logxen/contraptor/README.md

Contraptor
==========

Contraptor is a DIY open source construction set for experimental personal fabrication, desktop manufacturing, prototyping and bootstrapping. http://www.contraptor.org/
