logxen/contraptor/tags/contraptor-1.5.0/components/electronics/electronics.readme.htm

# Electronics

### Stepper Motors



I'm currently using cheap Applied Motion Products unipolar stepper motors 44A501711. They are rated for 2.3A / 2.3V / 60 oz*in. This is technically beyond the limit of the stepper driver board, but because the board has current limiting capability, it works. I do make sure that the driver boards are heatsinked to the frame whenever I run these steppers.

### Stepper Driver Board

The set originally used Reprap stepper driver board v1.1, but this board is no longer available. You can buy very similar v1.2 stepper driver board from makerbot.com, which sells kits derived from Reprap designs. One board kit costs $26: http://store.makerbot.com/electronics/electronics-kits/stepper-motor-dri...

The RepRap wiki has detailed instructions (http://www.reprap.org/bin/view/Main/Stepper_Motor_Driver_1_2) for soldering this board. The difference between v1.1 and v1.2 is primarily in connectors: v1.2 uses CAT5 for MIN/MAX and IDC for Arduino connection (compare to v1.1 (http://www.reprap.org/bin/view/Main/Stepper_Motor_Driver_1_1)). I actually prefer the MIN/MAX connectors in v1.1, and they can still be used with v1.2 board.

Alternatively, you can order parts through the parts lister on the Reprap page and etch your own PCBs using these the trace files here: http://forums.reprap.org/read.php?13,8181

You need as many boards as the axes you want to control at a time.

### Arduino Controller

You can buy it for little over $30 (http://www.arduino.cc/en/Main/Buy). You can also make or get Freeduino (http://www.google.com/search?q=freeduino) which may be cheaper.

### ATX power supply

The PSU can be scavenged from just about any old PC or bought at computer supply stores.
