logxen/contraptor/tags/contraptor-1.5.0/contraptions/mini-router/_screenshot.png

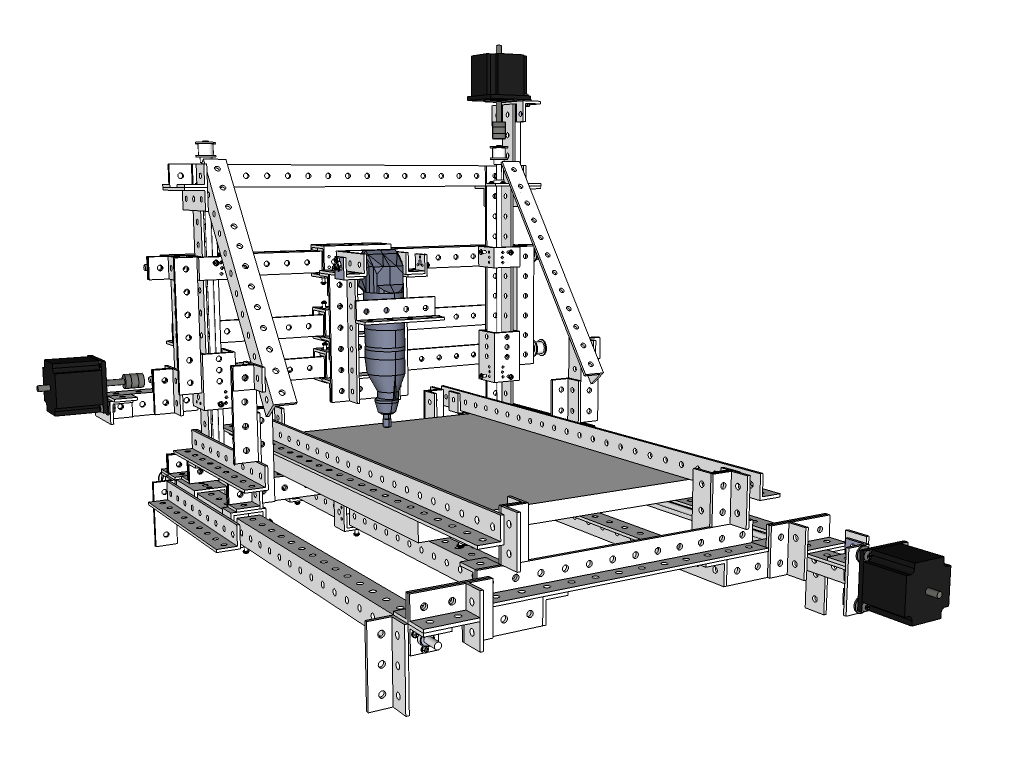
tags/contraptor-1.5.0/contraptions/mini-router/_screenshot.png
