logxen/contraptor/tags/contraptor-1.5.0/examples/belt-drive/_screenshot.png

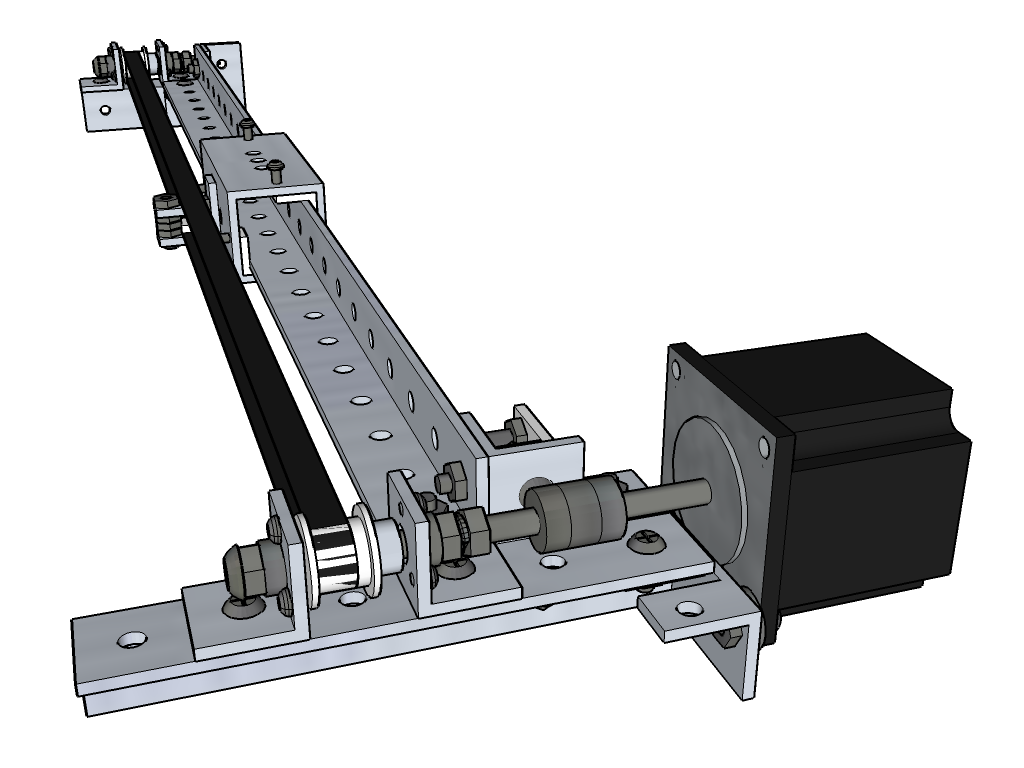
tags/contraptor-1.5.0/examples/belt-drive/_screenshot.png
