logxen/contraptor/tags/contraptor-1.5.0/examples/leadscrew-drive/_screenshot.png

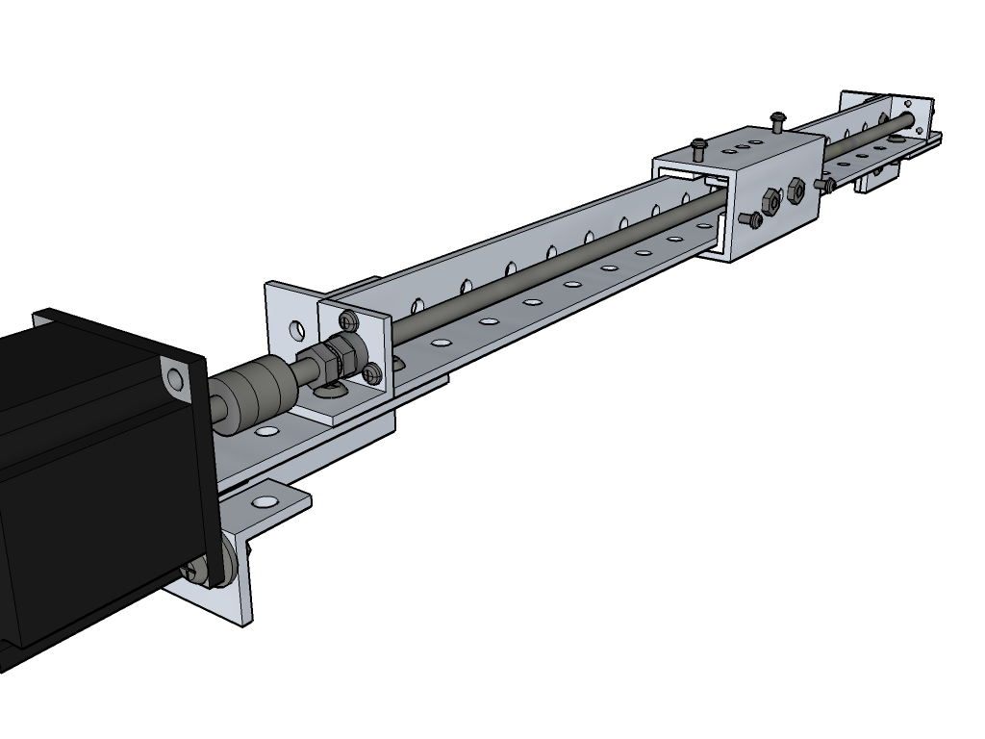
tags/contraptor-1.5.0/examples/leadscrew-drive/_screenshot.png
