logxen/contraptor/trunk/contraptions/xy-plotter/_screenshot.png

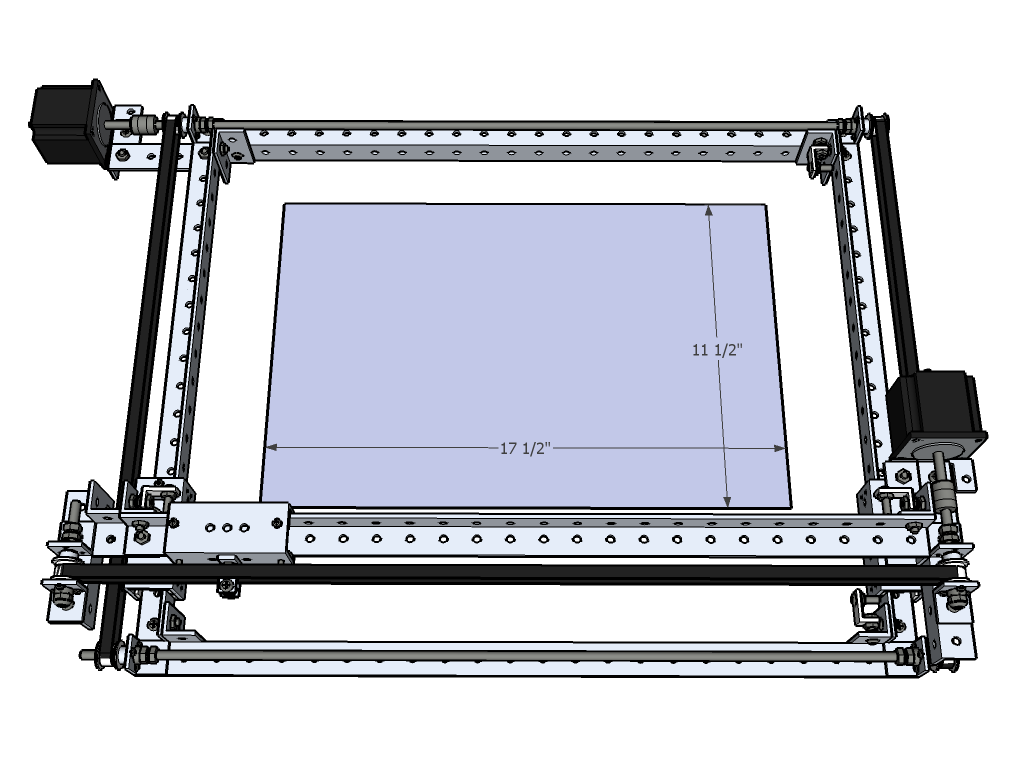
trunk/contraptions/xy-plotter/_screenshot.png
