logxen/contraptor/tags/contraptor-1.5.0/components/belt-clamp/belt-clamp.3d.DXF

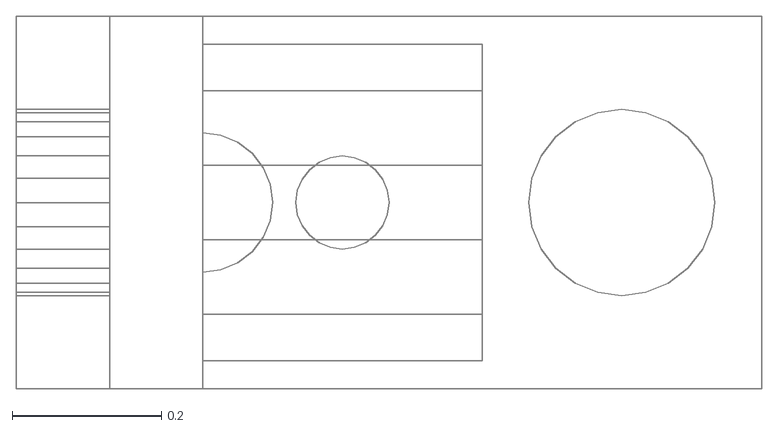
[picture p5: CAD file, 2009-03-20]
tags/contraptor-1.5.0/components/belt-clamp/belt-clamp.3d.DXF
1.00 x 0.5
