logxen/contraptor/tags/contraptor-1.5.0/components/leadnut-mount/leadnut-mount.3d.DXF

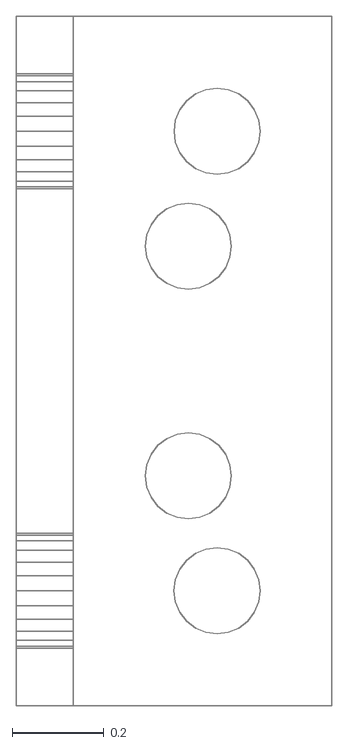
[picture p6: CAD file, 2009-03-20]
tags/contraptor-1.5.0/components/leadnut-mount/leadnut-mount.3d.DXF
0.688 x 1.50
