logxen/contraptor/tags/contraptor-1.5.0/components/motor-mount-nema23/motor-mount-nema23.3d.DXF

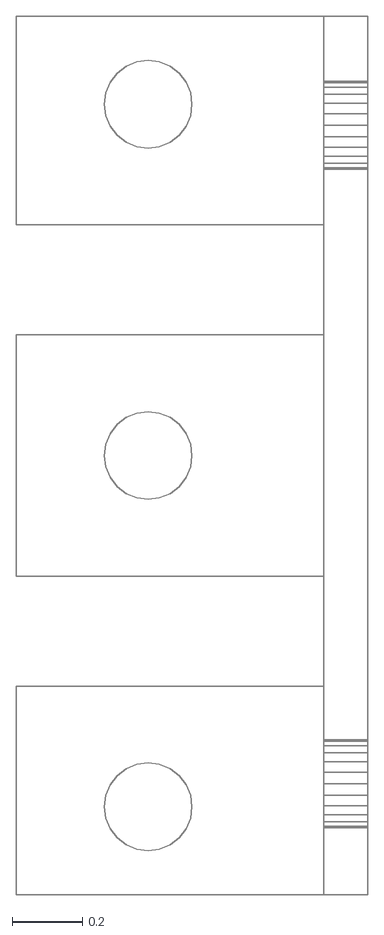
[picture p7: CAD file, 2009-03-20]
tags/contraptor-1.5.0/components/motor-mount-nema23/motor-mount-nema23.3d.DXF
1.00 x 2.50
