logxen/contraptor/tags/contraptor-1.5.0/components/perforated-angle/perforated-angle.3d.dxf

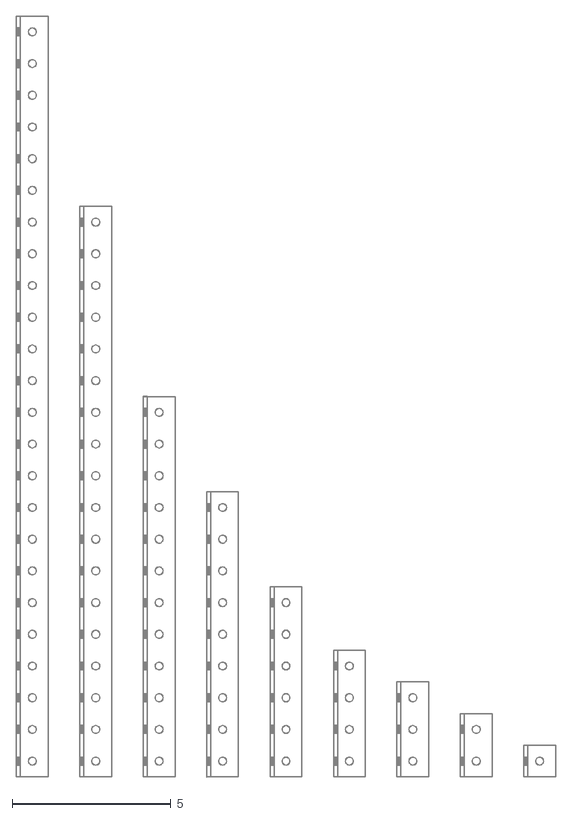
[picture p8: CAD file, 2009-03-20]
tags/contraptor-1.5.0/components/perforated-angle/perforated-angle.3d.dxf
17.0 x 24.0
