logxen/contraptor/tags/contraptor-1.5.0/components/shaft-mount/shaft-mount.3d.DXF

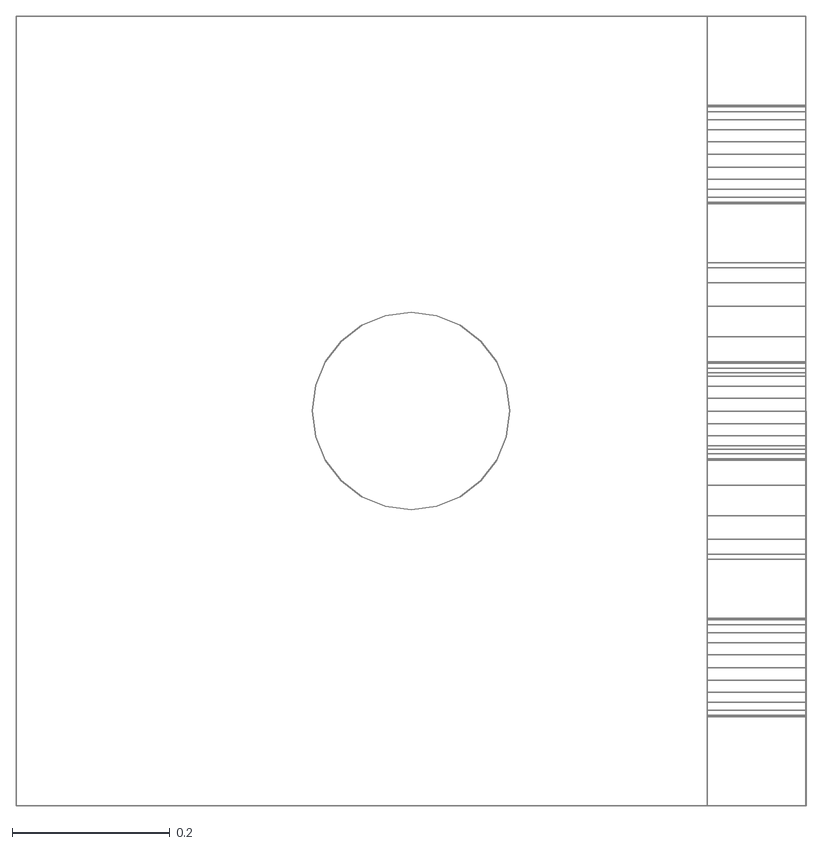
[picture p9: CAD file, 2009-03-20]
tags/contraptor-1.5.0/components/shaft-mount/shaft-mount.3d.DXF
1.00 x 1
