logxen/contraptor/tags/contraptor-1.5.0/components/sliding-elements/sliding-element-1/sliding-element-1.3d.DXF

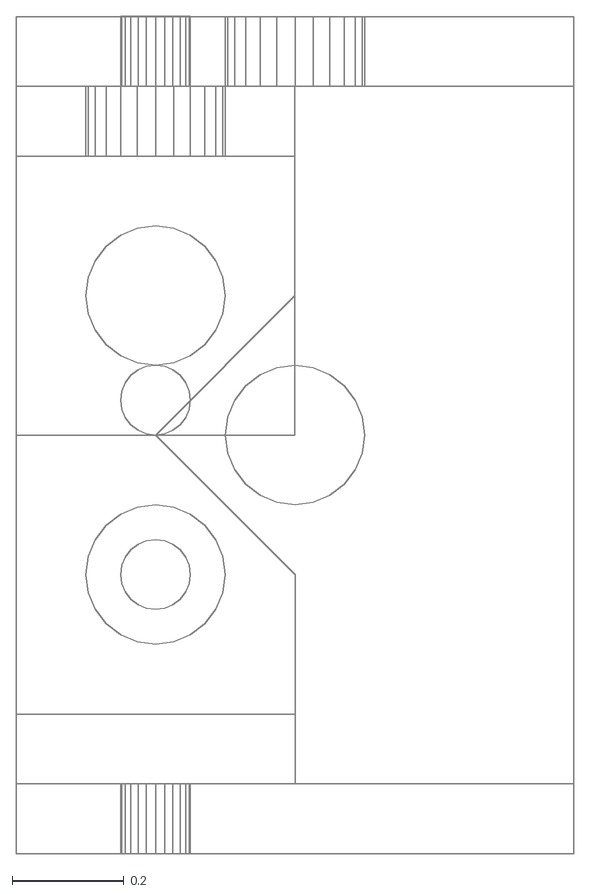
[picture p10: CAD file, 2009-03-20]
tags/contraptor-1.5.0/components/sliding-elements/sliding-element-1/sliding-element-1.3d.DXF
1.00 x 1.50
