logxen/contraptor/tags/contraptor-1.5.0/components/sliding-elements/sliding-element-3.5/sliding-element-3.5.3d.DXF

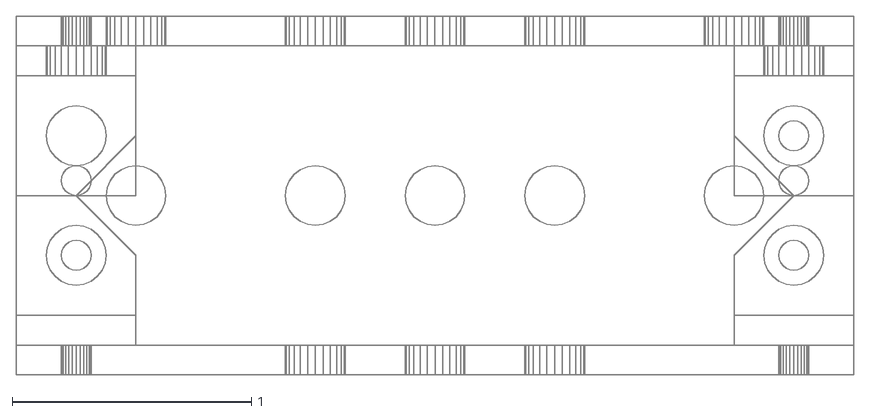
[picture p12: CAD file, 2009-03-20]
tags/contraptor-1.5.0/components/sliding-elements/sliding-element-3.5/sliding-element-3.5.3d.DXF
3.50 x 1.50
