logxen/contraptor/trunk/components/motor-mount-nema23/motor-mount-nema23.3d.DXF

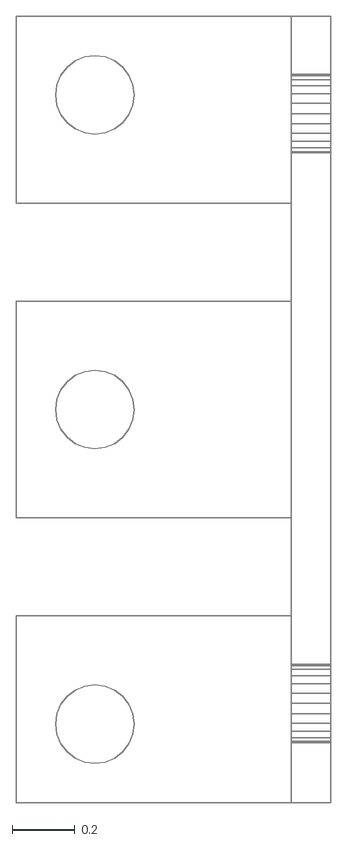
[picture p13: CAD file, 2009-09-23]
trunk/components/motor-mount-nema23/motor-mount-nema23.3d.DXF
1.00 x 2.50
