logxen/contraptor/tags/contraptor-1.5.0/components/coupling-nut-clamp/coupling-nut-clamp.3d.DXF

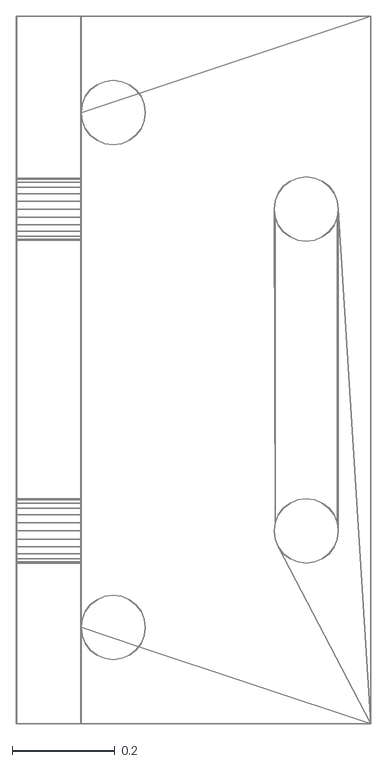
[picture p15: CAD file, 2009-03-20]
tags/contraptor-1.5.0/components/coupling-nut-clamp/coupling-nut-clamp.3d.DXF
0.688 x 1.38
