logxen/contraptor/(list of files, cad)

Other CAD files:
tags/contraptor-1.5.0/components/belt-clamp/belt-clamp.3d.skp
tags/contraptor-1.5.0/components/captive-nut/captive-nut.3d.skp
tags/contraptor-1.5.0/components/contraptor.3d.skp
tags/contraptor-1.5.0/components/coupling-nut-clamp/coupling-nut-clamp.3d.skp
tags/contraptor-1.5.0/components/leadnut-mount/leadnut-mount.3d.skp
tags/contraptor-1.5.0/components/motor-mount-nema23/motor-mount-nema23.3d.skp
tags/contraptor-1.5.0/components/perforated-angle/perforated-angle.3d.skp
tags/contraptor-1.5.0/components/shaft-mount/shaft-mount.3d.skp
tags/contraptor-1.5.0/components/sliding-elements/sliding-element-1/sliding-element-1.3d.skp
tags/contraptor-1.5.0/components/sliding-elements/sliding-element-2.5/sliding-element-2.5.3d.skp
tags/contraptor-1.5.0/components/sliding-elements/sliding-element-3.5/sliding-element-3.5.3d.skp
tags/contraptor-1.5.0/examples/belt-drive/belt-drive.3d.skp
tags/contraptor-1.5.0/examples/leadscrew-drive/leadscrew-drive.3d.skp
trunk/components/contraptor.3d.skp
trunk/components/motor-mount-nema23/motor-mount-nema23.3d.skp
trunk/contraptions/xy-plotter/xy-plotter.3d.skp
