logxen/contraptor/trunk/components/electronics/wiring.pdf

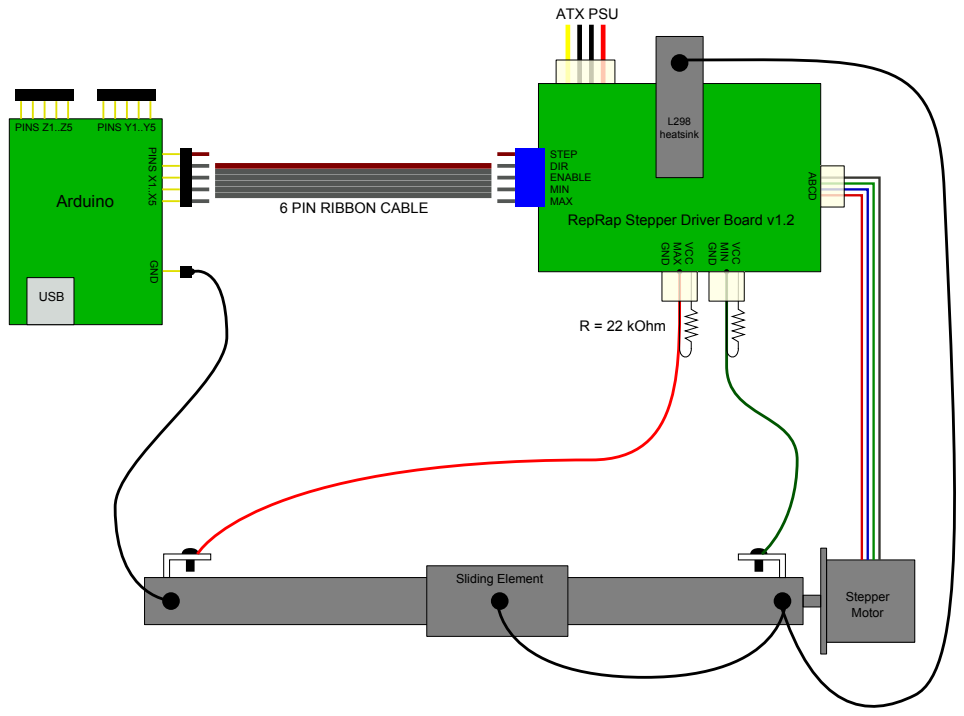
[picture p16: page 1]
PINS Y1..Y5; Arduino; Stepper Motor; Sliding Element; MIN; R = 22 kOhm; ATX PSU; L298 heatsink; USB; ABC; PIN; PINS Z1..Z5

STEP
DIR
ENABLE
MIN
MAX
RepRap Stepper Driver Board v1.2

6 PIN RIBBON CABLE
