logxen/contraptor/trunk/components/motor-mount-nema23/motor-mount-nema23.template.pdf

# CONTRAPTOR

### garageFab.cc/contraptor

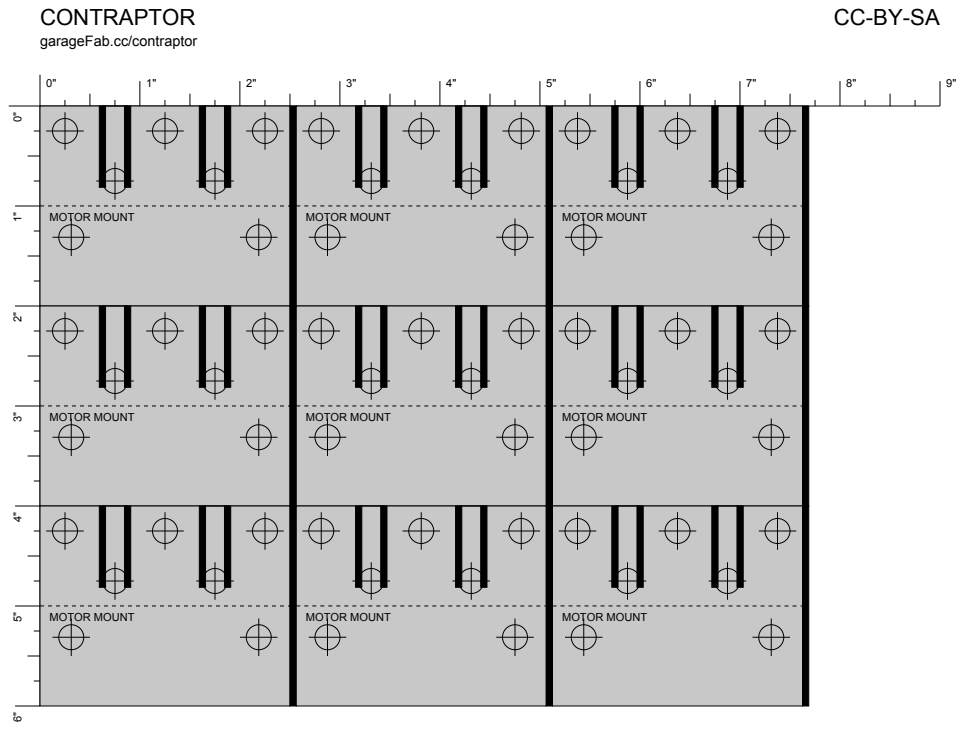
[picture p17: page 1]
MOTOR MOUNT
