logxen/contraptor/tags/contraptor-1.5.0/components/belt-clamp/belt-clamp.template.pdf

# CONTRAPTOR

### garageFab.cc/contraptor

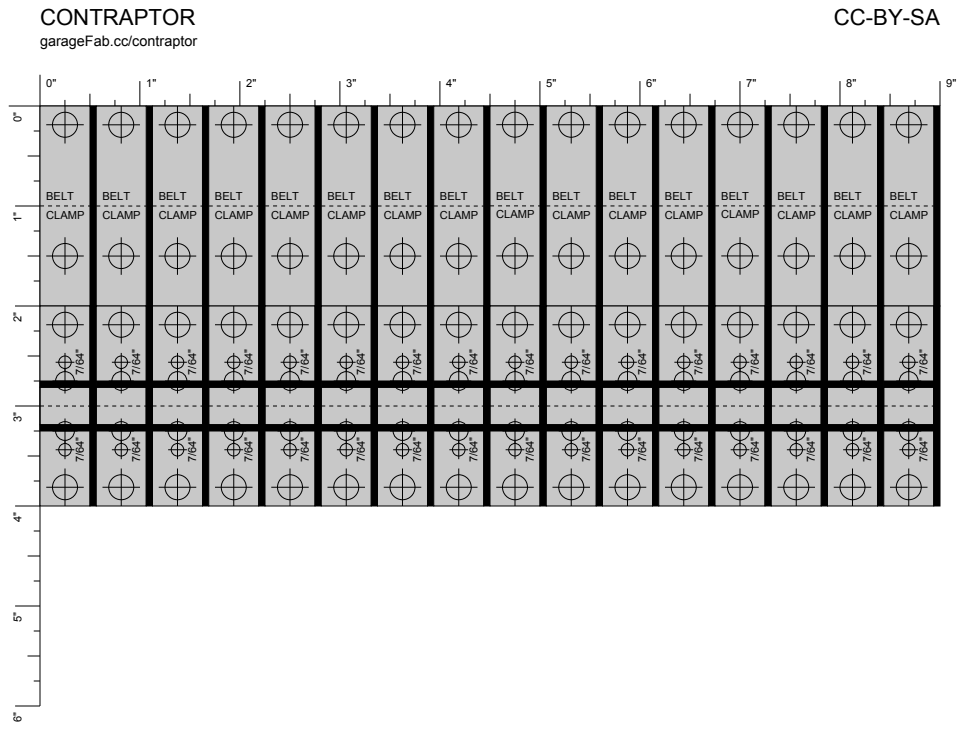
[picture p18: page 1]
BELT; CLAMP
