logxen/contraptor/tags/contraptor-1.5.0/components/captive-nut/captive-nut.template.pdf

# CONTRAPTOR

### garageFab.cc/contraptor

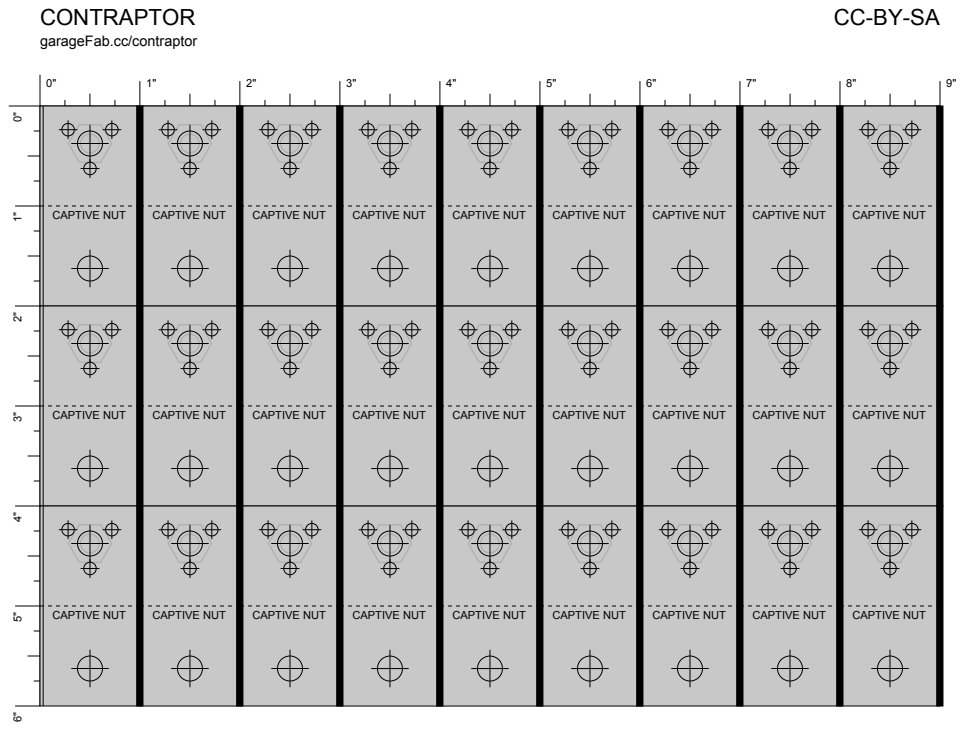
[picture p19: page 1]
CAPTIVE NUT
