logxen/contraptor/tags/contraptor-1.5.0/components/coupling-nut-clamp/coupling-nut-clamp.template.pdf

# CONTRAPTOR

### garageFab.cc/contraptor

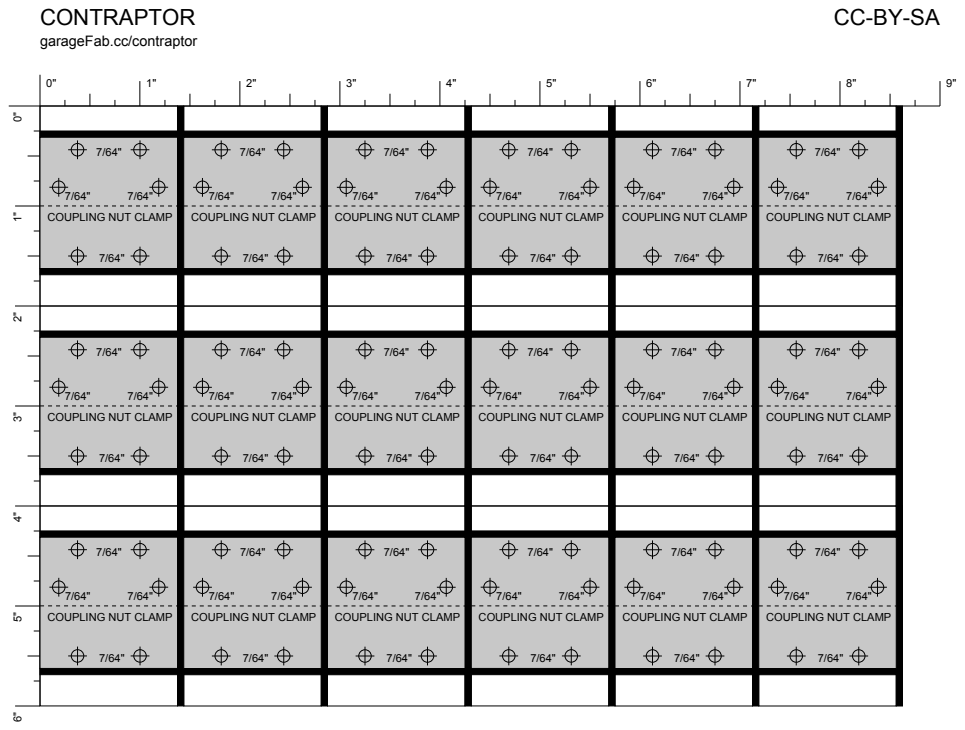
[picture p20: page 1]

COUPLING NUT CLAMP
