logxen/contraptor/tags/contraptor-1.5.0/components/electronics/wiring.pdf

## ATX PSU

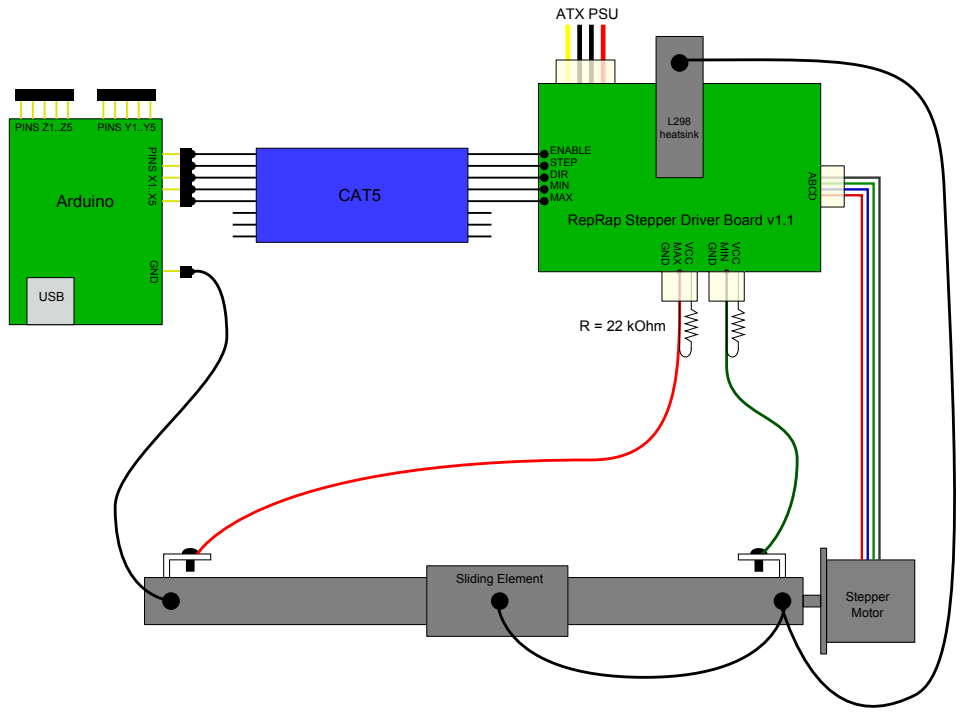
[picture p21: page 1]
ENABLE STEP DIR; MIN CAT5; MAX; PINS Y1..Y5; Arduino; Stepper Motor; Sliding Element; MIN; R = 22 kOhm; L298 heatsink; USB; ABC; PIN; PINS Z1..Z5

RepRap Stepper Driver Board v1.1
