logxen/contraptor/tags/contraptor-1.5.0/components/leadnut-mount/leadnut-mount.template.pdf

# CONTRAPTOR

### garageFab.cc/contraptor

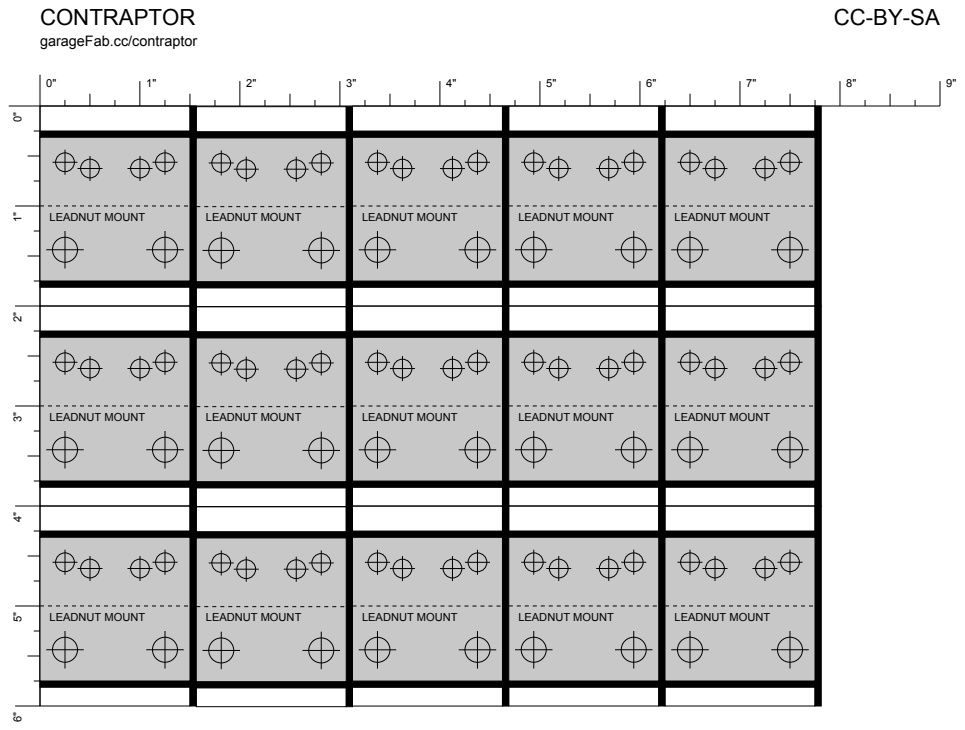
[picture p22: page 1]
LEADNUT MOUNT
