logxen/contraptor/tags/contraptor-1.5.0/components/motor-mount-nema23/motor-mount-nema23.template.pdf

# CONTRAPTOR

### garageFab.cc/contraptor

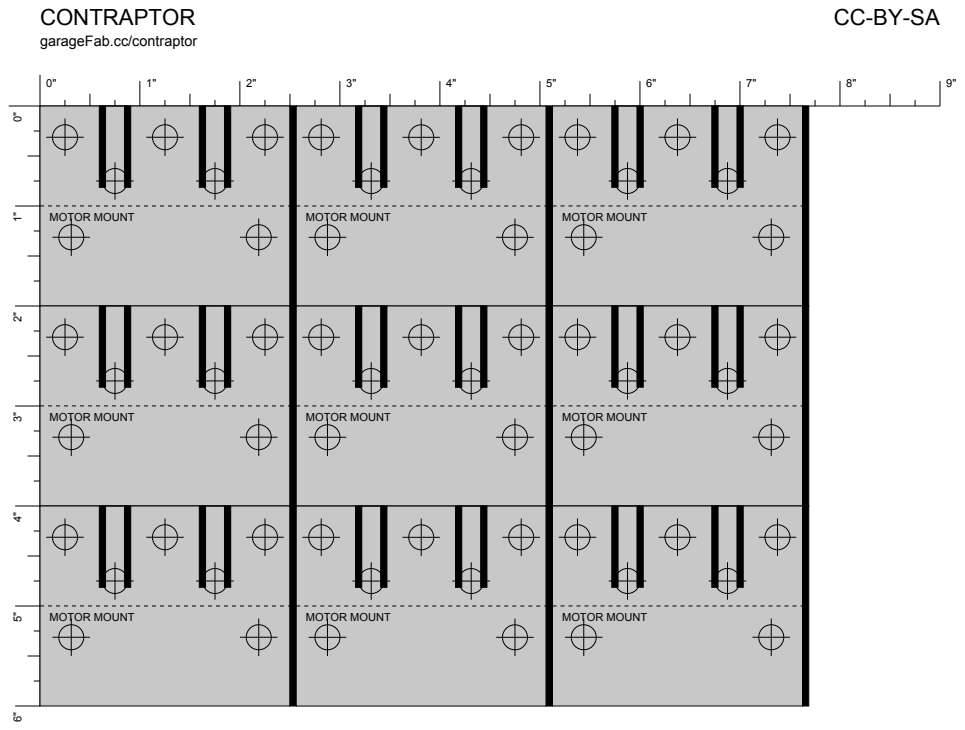
[picture p23: page 1]
MOTOR MOUNT
