logxen/contraptor/tags/contraptor-1.5.0/components/shaft-mount/shaft-mount.template.pdf

# CONTRAPTOR

### garageFab.cc/contraptor

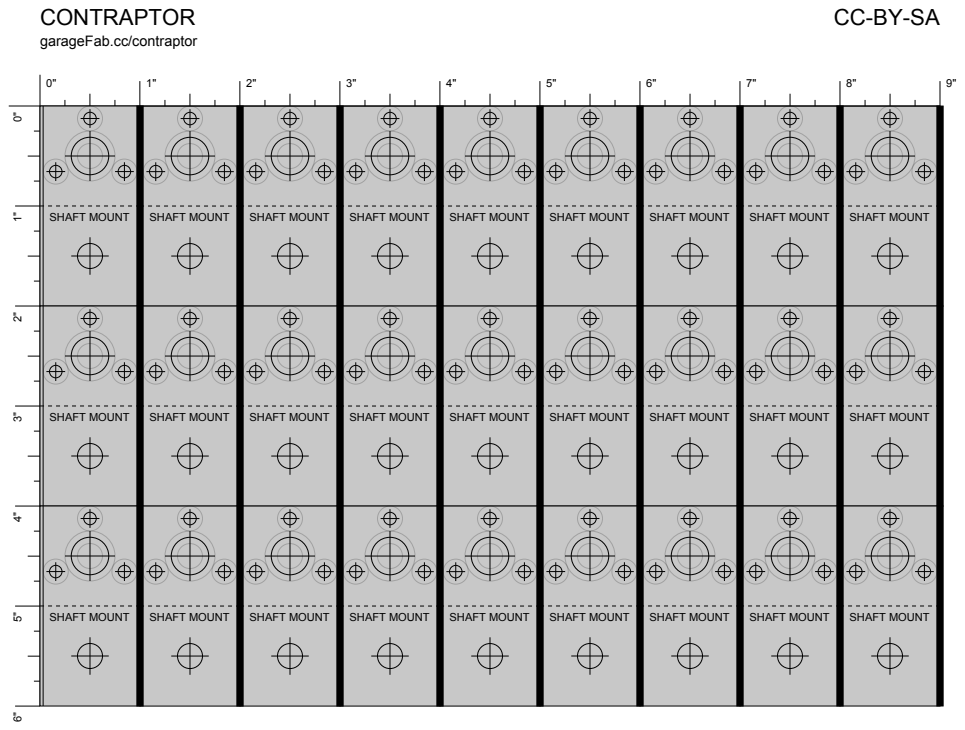
[picture p24: page 1]
SHAFT MOUNT
