logxen/contraptor/trunk/components/perforated-angle/perforated-angle.template.pdf

# CONTRAPTOR

### garageFab.cc/contraptor

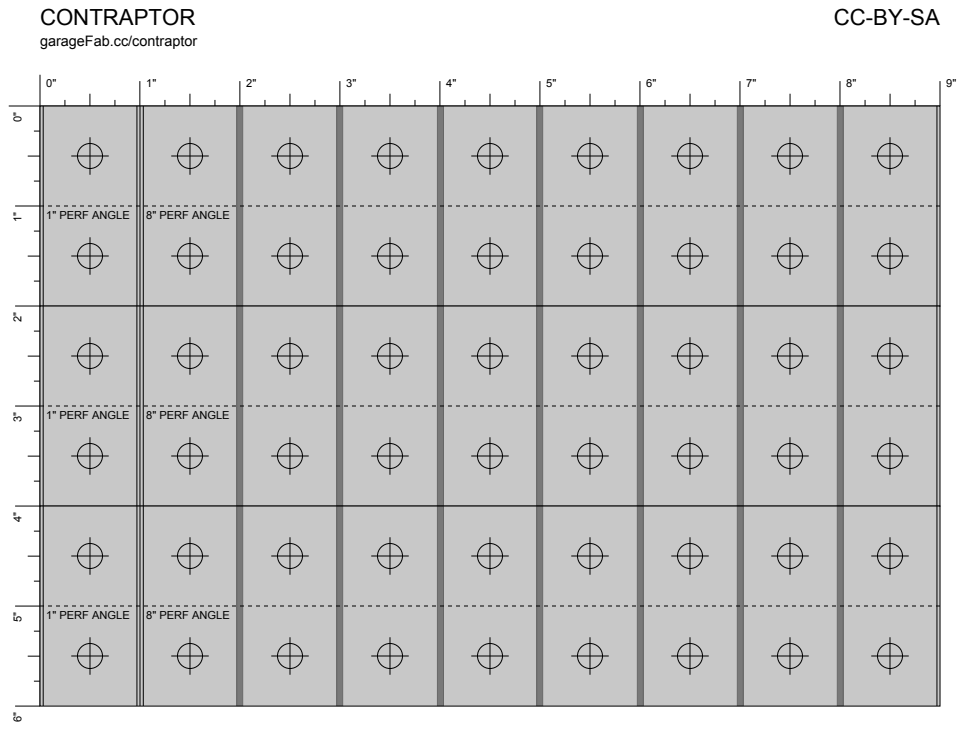
[picture p25: page 1]
1" PERF ANGLE; 8" PERF ANGLE
