logxen/contraptor/tags/contraptor-1.5.0/components/perforated-angle/perforated-angle.template.pdf

# CONTRAPTOR

### garageFab.cc/contraptor

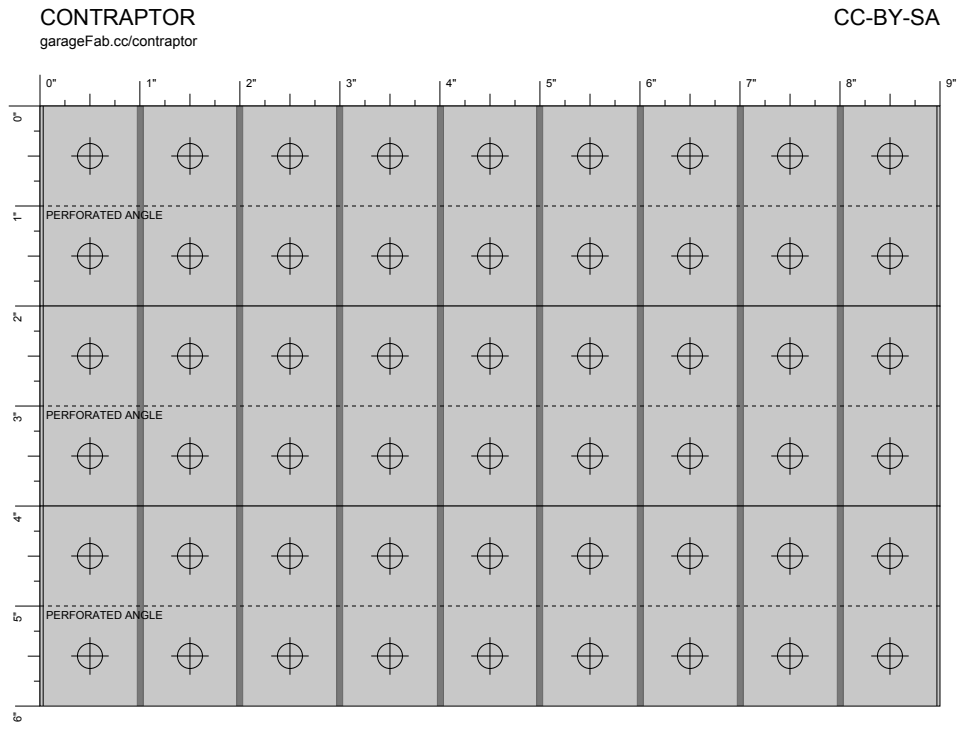
[picture p26: page 1]
PERFORATED ANGLE
