logxen/contraptor/tags/contraptor-1.5.0/components/sliding-elements/sliding-element-1/sliding-element-1.template.pdf

# CONTRAPTOR

### garageFab.cc/contraptor

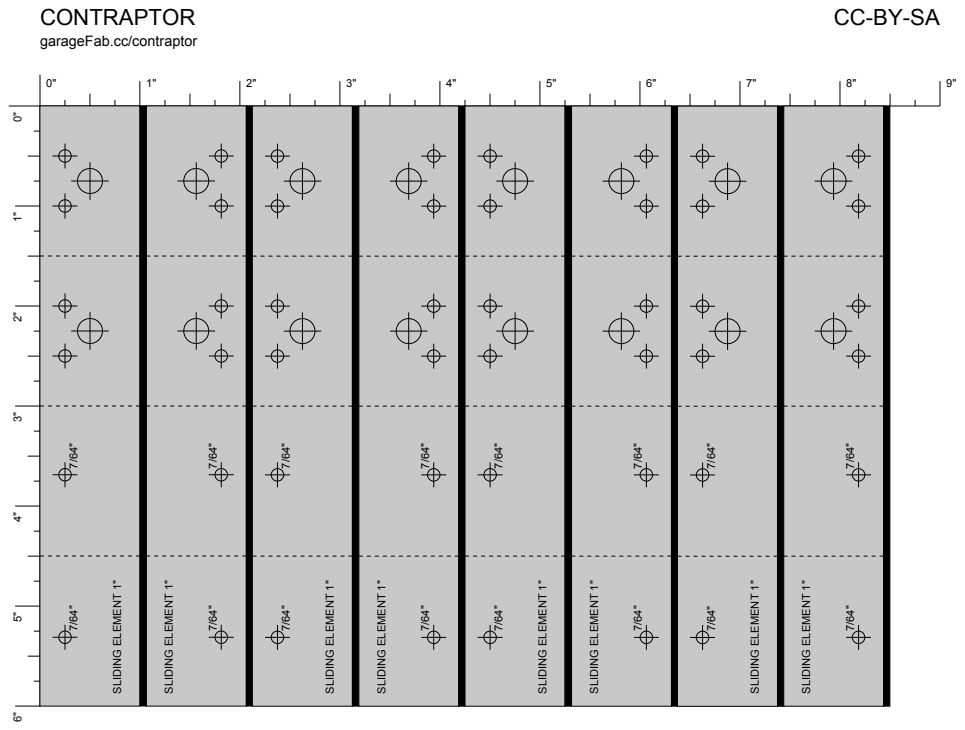
[picture p27: page 1]
SLIDIN; G ELEMEN
