logxen/contraptor/tags/contraptor-1.5.0/components/sliding-elements/sliding-element-2.5/sliding-element-2.5.template.pdf

# CONTRAPTOR

### garageFab.cc/contraptor

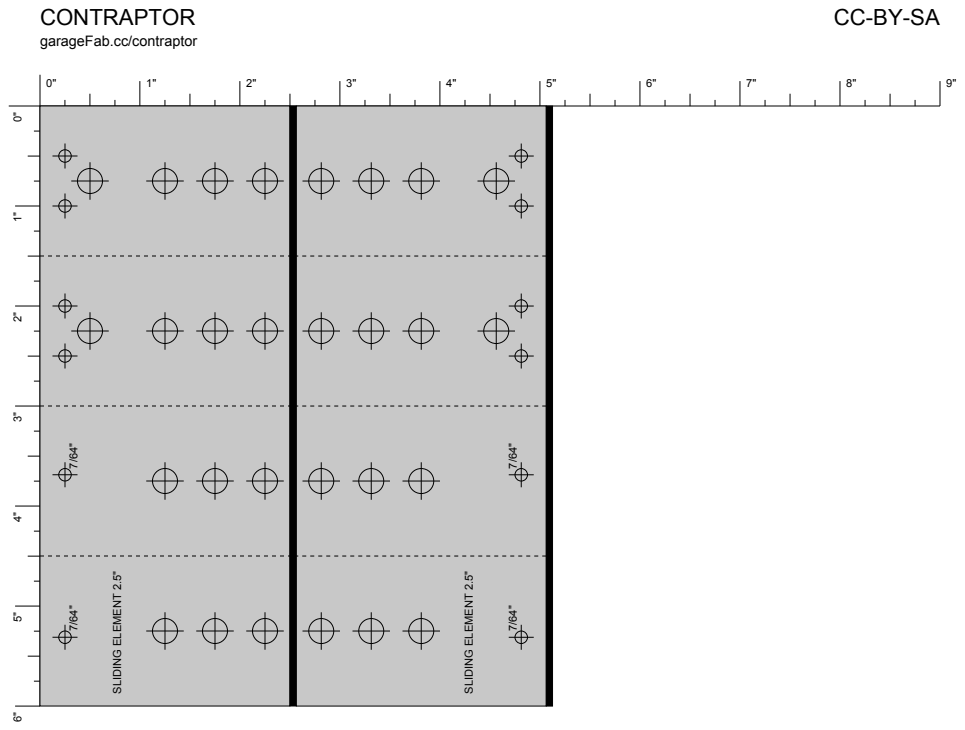
[picture p28: page 1]
SLIDIN; G ELEMEN
