logxen/contraptor/tags/contraptor-1.5.0/components/sliding-elements/sliding-element-3.5/sliding-element-3.5.template.pdf

# CONTRAPTOR

### garageFab.cc/contraptor

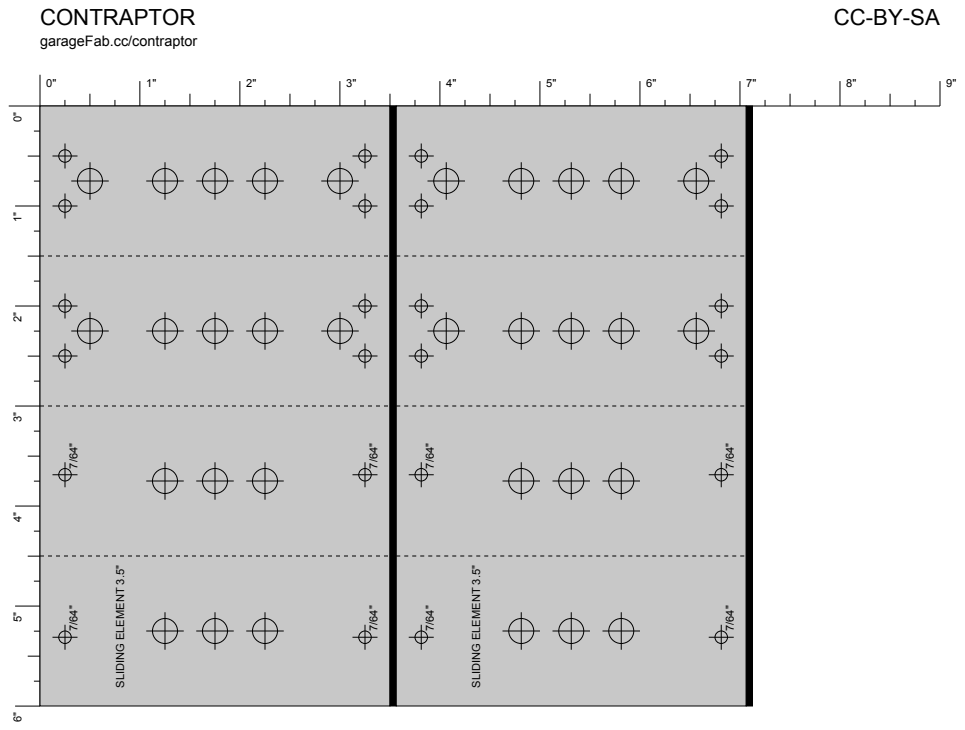
[picture p29: page 1]
SLIDIN; G ELEMEN
