logxen/contraptor/trunk/firmware/reprap_new_firmware/reprap_new_firmware.pde

#include "reprap_new_firmware.h"

#define COMMAND_SIZE 128
char command[COMMAND_SIZE];
byte serial_count;
int no_data = 0;
long idle_time;
boolean comment = false;
boolean bytes_received = false;

long current_steps[3];

Move move_queue[2];
volatile Move *current_move_ptr, *next_move_ptr;

// Following all need to be volatile because they are
// being both read and set by the main and interrupt handler routines
volatile bool have_next_move = false;
volatile bool move_queue_lock_main = false;
volatile bool moving = false;

unsigned int timer1LoadValue, nextTimer1LoadValue;

void setup()
{
  Serial.begin(38400); // Don't need to give a baud rate because it is fixed at 19200 in our optimised version
  init_steppers();
  init_extruder();
  init_process_string();
  calculateAccelConstants();
  SetupTimer1();
  println("start");
}

void loop()
{
  char c;
  
  //keep it hot!
  extruder_manage_temperature();

  //read in characters if we got them.
  if (Serial.available() > 0)
  {
    c = Serial.read();
    no_data = 0;

    //newlines are ends of commands.
    if (c != '\n')
    {
      // Start of comment - ignore any bytes received from now on
      if (c == '(')
        comment = true;

      // If we're not in comment mode, add it to our array.
      if (!comment)
      {
        command[serial_count] = c;
        serial_count++;
      }
      if (c == ')')
        comment = false; // End of comment - start listening again
    }

    bytes_received = true;
    idle_time = millis();
  }
  //mark no data if nothing heard for 100 milliseconds
  else
  {
    if ((millis() - idle_time) >= 100)
    {
      no_data++;
      idle_time = millis();
    }
  }

  //if theres a pause or we got a real command, do it
  if (bytes_received && (c == '\n' || no_data ))
  {
    //process our command!
    process_string(command, serial_count);

    //clear command.
    init_process_string();
  }
}
