logxen/contraptor/(commit log)

2009-03-23 updated wiring diagram to show connection of other axes to Arduino
2009-03-23 Added component CSV Fixed length of leadscrews Updated screenshot
    [components.csv]
2009-03-23 Replaced components.csv with BoM.cvs
    [BoM.csv, components.csv]
2009-03-24 Updated BoM with more info: -calculated parts/materials for components -vendors, part#s, links
    [BoM.csv]
2009-03-24 Removed simple assemblies Removed common BoM (need to change it completely) Added component names to file names Added extra suffix (3d,template) to files
    [belt-clamp.3d.DXF, belt-clamp.3d.skp, bom.csv, captive-nut.3d.DXF, captive-nut.3d.skp, coupling-nut-clamp.3d.DXF, coupling-nut-clamp.3d.skp, delrin-nut.3d.DXF]
2009-03-24 More renaming screenshot -> _screenshot, mini-router renaming
    [mini-router.BoM.csv]
2009-03-24 Renaming assemblies in the manner of name.type.format
2009-03-24 Updated BoM with cost information
    [mini-router.BoM.csv]
2009-03-25 Added new BoM for the default configuration of the set
    [contraptor.BoM.csv]
2009-03-27 moving source to trunk
    [belt-clamp.3d.DXF, belt-clamp.3d.skp, captive-nut.3d.DXF, captive-nut.3d.skp, contraptor.BoM.csv, coupling-nut-clamp.3d.DXF, coupling-nut-clamp.3d.skp, delrin-nut.3d.DXF]
2009-03-27 Importing source to trunk
    [belt-clamp.3d.DXF, belt-clamp.3d.skp, captive-nut.3d.DXF, captive-nut.3d.skp, contraptor.BoM.csv, coupling-nut-clamp.3d.DXF, coupling-nut-clamp.3d.skp, delrin-nut.3d.DXF]
2009-03-27 removed delrin-nut from components (for the release)
2009-03-27 remove again
    [delrin-nut.3d.DXF, delrin-nut.3d.skp]
2009-03-29 Changed default leadscrew length to 3ft
2009-03-31 Renamed assemblies to examples
2009-04-01 Unzipped Sketchup file of the set
    [contraptor.3d.skp]
2009-04-07 Commiting examples with readme files and unzipped sketchup files
    [belt-drive.3d.skp, leadscrew-drive.3d.skp]
2009-04-07 Adding Sketchup files for parallel belts and leadscrews
    [parallel-belts.3d.skp, parallel-leadscrews.3d.skp]
2009-04-09 Updated examples, removed parallel leadscrew/belt assemblies - try 2
    [belt-drive.3d.skp, leadscrew-drive.3d.skp, parallel-belts.3d.skp, parallel-leadscrews.3d.skp]
2009-04-09 Releasing 1.5.0
    [belt-clamp.3d.DXF, belt-clamp.3d.skp, belt-drive.3d.skp, captive-nut.3d.DXF, captive-nut.3d.skp, contraptor.3d.skp, contraptor.BoM.csv, coupling-nut-clamp.3d.DXF]
2009-04-10 added missing electrnics to minirouter bom and rearranged contraptor sketchup file
    [contraptor.3d.skp, mini-router.BoM.csv]
2009-04-10 trunk: added missing electronics to minirouter bom and rearranged contraptor sketchup file
    [contraptor.3d.skp, mini-router.BoM.csv]
2009-07-13 commit XY plotter sketchup file and BoM
    [xy-plotter.3d.skp, xy-plotter.BoM.csv]
2009-07-13 updated xy plotter BoM with 54" belt price/link
    [xy-plotter.BoM.csv]
2009-07-13 xy plotter BoM cleanup
    [xy-plotter.BoM.csv]
2009-07-24 changed motor to look more like Contraptor default motor, cleaned up naming of components
    [contraptor.3d.skp]
2009-07-26 Updated XY plotter design to use extra shaft mounts to support threaded rods in the middle
    [xy-plotter.3d.skp, xy-plotter.BoM.csv]
2009-07-29 Added info on connecting/configuring firmware for SMD v1.2 as well as mention of more powerful motors
2009-09-04 BOM update: PTFE angle -> UHMWPE channel, nylon screws
    [contraptor.BoM.csv]
2009-09-04 Change 42: "more powerful motors" undo
2009-09-04 Updated materials page with UHMWPE, removed iframed latest version BOM
2009-09-04 Update make instructions: PTFE angle -> UHMWPE channel, nylon screws Update electronics: how to use the power switch on ATX PSU
2009-09-04 PTFE->UHMWPE switch - some minor fixes in readme files
2009-09-19 Added 1" cut lines to perforated angle templates
2009-09-19 Added 1" cut lines to perforated angle templates - PDF
2009-09-23 Fixed motor mount inconsistency
    [contraptor.3d.skp, motor-mount-nema23.3d.DXF, motor-mount-nema23.3d.skp]
2010-03-02 Updated wiring diagram to SMD v1.2
2010-03-02 Added Chris Meighan's version of Arduino GCode Interpreter (16k optimizations mostly removed)
